manweile/HVP/Docs/Fritzing/HVP_Uno_bb.pdf

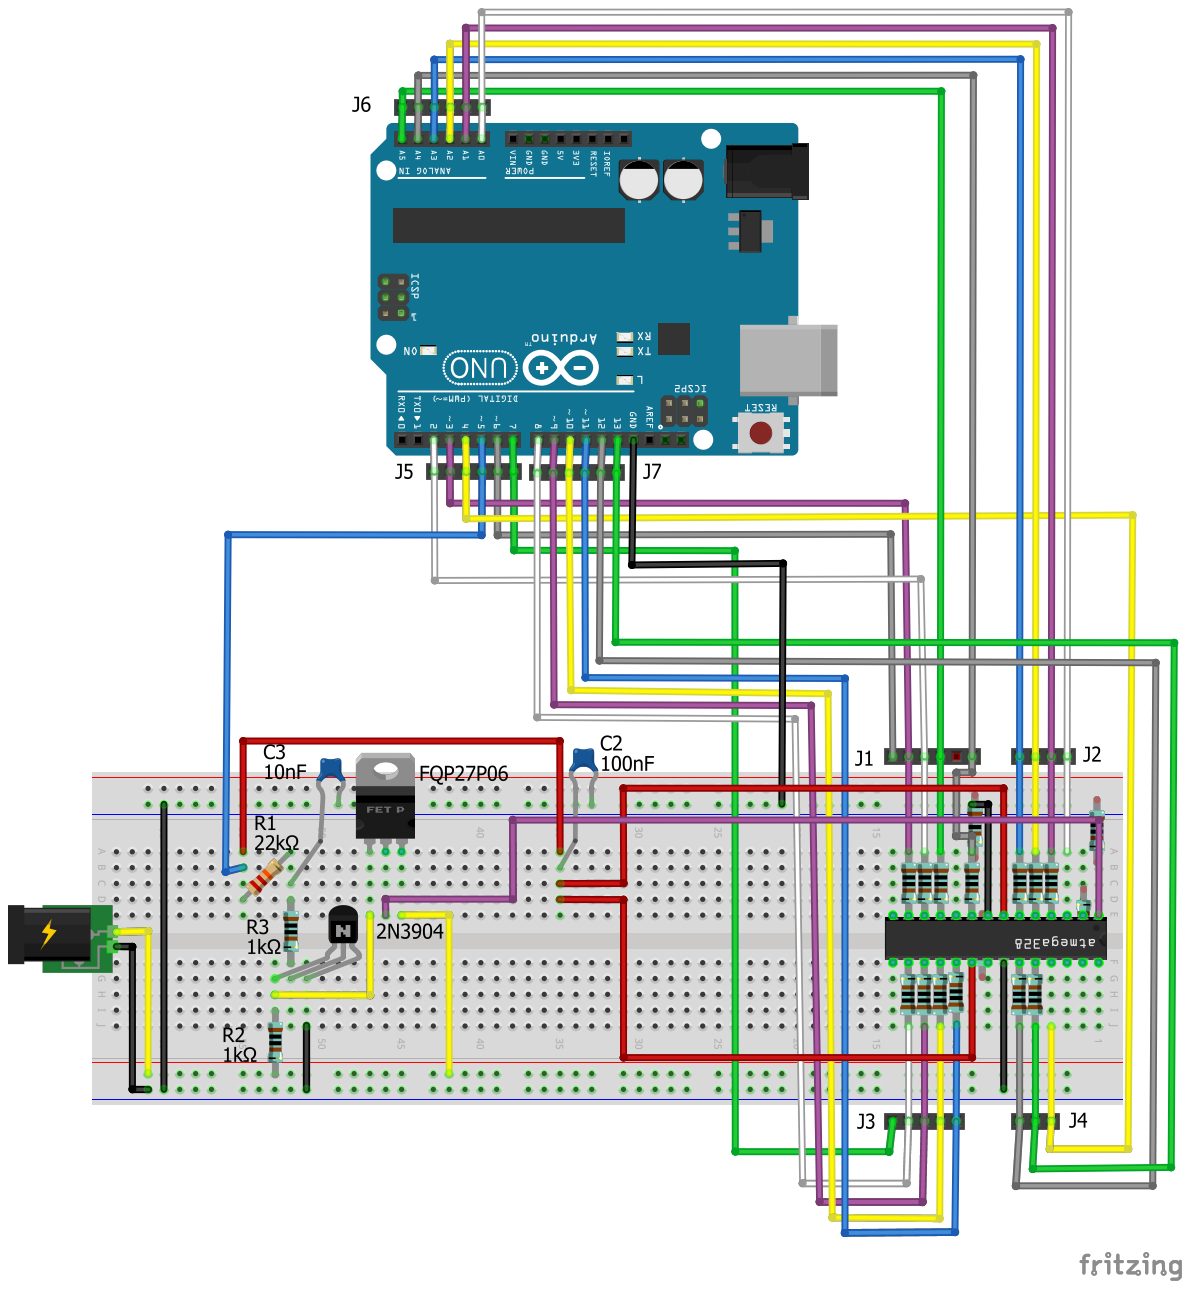
[picture p9: page 1]
