manweile/HVP/(list of files, drawings)

Other design files:
Docs/Fritzing/HVP_Uno.fzz
