manweile/HVP/(commit log)

2024-12-08 update fritzing
    [HVP_Uno.fzz]
2024-12-08 exported bread board and schematic
